beep0909/FerroAudioAmp/BOM.xls

PCB
Comment | Description | Designator | Footprint | LibRef | Quantity
100nF |  | C1, C3, C8 | 0603 | Cap | 3
33pF |  | C2 | 0603 | Cap | 1
10uF |  | C4, C7 | 0603 | Cap | 2
10nF |  | C5, C6 | 0603 | Cap | 2
RB521S30T1G | Diode Schottky 30V 200mA (DC) Surface Mount SOD-523 | D1, D2, D3, D4, D5, D6, D7, D8, D9, D10, D11, D12, D13, D14, D15, D16 | SOD523 | Diode Schottky | 16
B2B-XH-A(LF)(SN) | Connector Header Through Hole 2 position 0.098 (2.50mm) | J1, J2, J3, J4, J5, J6, J7, J8, J9, J10, J11, J12, J13, J14, J15, J16, POW1 | JST_B2B-XH-A(LF)(SN) | B2B-XH-A(LF)(SN) | 17
SJ1-3525N | 3.5 mm, Stereo, Right Angle, Through Hole, Audio Jack Connector | J_Audio1 | CUI_SJ1-3525N | SJ1-3525N | 1
100nH |  | L1 | 0603 | Ind | 1
DMN2056U-7 | N-Channel 20V 4A (Ta) 940mW Surface Mount SOT-23-3 | M1, M2, M3, M4, M5, M6, M7, M8, M9, M10, M11, M12, M13, M14, M15, M16 | SOT23_L | MOSFET-N | 16
MP1584EN_5V | DC-DC 6.5-28V in 5V out module | MD1 | MP1584EN_5V | MP1584EN_5V | 1
ARDUINO_NANO | ATSAMD21G18A Arduino Nano 33 IoT SAM D ARMÂ® CortexÂ®-M0+ MCU 32-Bit Embedded Evaluation Board | MD2 | SHIELD_ARDUINO_NANO | ARDUINO_NANO | 1
JUMPER 3 | Header, 3-Pin | P1 | HDR1X3 | Header 3 | 1
1K |  | R1, R2, R3, R4, R5, R6, R7, R8, R9, R10, R11, R12, R13, R14, R15, R16 | 0603 | Res | 16
200K |  | R17 | 0603 | Res | 1
1.2K |  | R18, R20, R24 | 0603 | Res | 3
0 |  | R19, R21, R22 | 0603 | Res | 3
22K |  | R23, R_L1, R_R1 | 0603 | Res | 3
MSGEQ7 | Seven Band Graphic Equalizer | U1 | DIP-8 | MSGEQ7 | 1
LM386 | Low Voltage Audio Power Amplifier | U2 | DIP-8 | LM386 | 1
2K | PC Pins Through Hole Trimmer Potentiometer Cermet 1 Turn Top Adjustment | VR1 | TRIM_3362P | 3362P | 1
10K | PC Pins Through Hole Trimmer Potentiometer Cermet 1 Turn Top Adjustment | VR2 | TRIM_3362P | 3362P | 1
DO NOT buy MSGEQ7 from China!!!!!!!!!!!!!!!!!
Get it from sparkfun!
Others
Item | Description | Quantity | Website
XY-S100L | 2.1 channel Bluetooth audio power amplifier module high and low bass subwoofer | 1 | https://www.aliexpress.com/item/1005002602440386.html
KK-P49/21 | Electric Magnet P49/21 Sucker DC 24V Lifting 40Kg 400N Solenoid Electromagnet | 1 | https://www.aliexpress.com/item/32548838511.html
Glass bottle | 125ml glass bottle | 1 | https://item.taobao.com/item.htm?spm=a1z09.2.0.0.2a902e8dQaJcZc&id=628821882199&_u=oufkvpbafc4
24V adapter | 24V 5A adapter | 1 | Amazon
JST XH 2.54 2p plug | 100Sets XH Pitch 2.54mm 2Pin Single-Head Wire To Board Connector 10cm 26AWG With Socket | 2 | https://www.aliexpress.com/item/32866129450.html?pdp_ext_f=%7B%22sku_id%22%3A%2265537364588%22%7D
24V Led strip |  | 1 | Amazon or Aliexpress
Speaker | build-in speaker | 2 | https://www.aliexpress.com/item/32816252198.html?pdp_ext_f=%7B%22sku_id%22%3A%2264715469662%22%7D
Speaker | Passive Speaker | 2 | Amazon
Ferrorfluid | EFH1 Ferrorfluid 50ml | 1 | Amazon
Screw | M2 x 6mm | 4 | Amazon
Screw | self tapping 4G x12mm | 10 | Amazon
M2 Screw Spacer | 3mm + 3mm M2 spacer | 4 | Amazon
Audio cable | 3.5mm jack audio cable | 1 | Amazon
Guide to make ferrofluid bottle:
1. Wash glass bottle with 99.8% IPA and then add 100ml saturated salt (NaCl) solution. 2. Add approx. 30ml ferrofluid.
