beep0909/FerroAudioAmp/Casing/Build-in Speaker Version/MagCap.SLDPRT

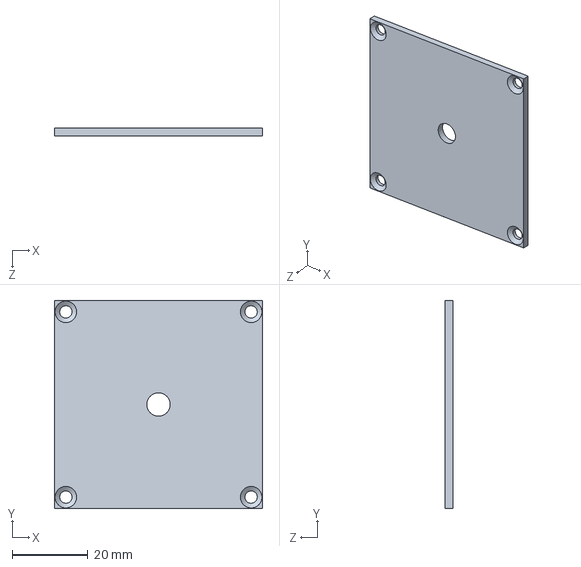
[picture p1: CAD file, 2022-01-24]
Casing/Build-in Speaker Version/MagCap.SLDPRT
55.0 x 55.0 x 2.00 mm
