beep0909/FerroAudioAmp/Casing/Build-in Speaker Version/InnerCap-spk.SLDPRT

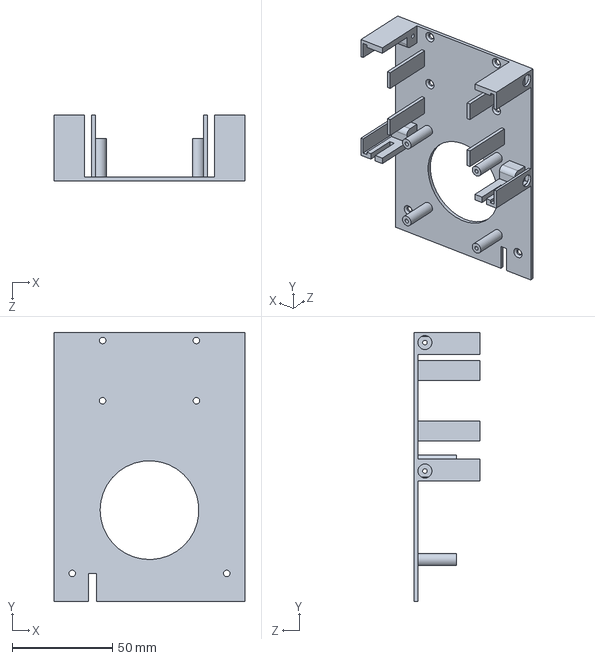
[picture p2: CAD file, 2022-01-24]
Casing/Build-in Speaker Version/InnerCap-spk.SLDPRT
95.0 x 134.0 x 33.0 mm
