beep0909/FerroAudioAmp/Casing/External Passive Speaker Version/Case2.SLDPRT

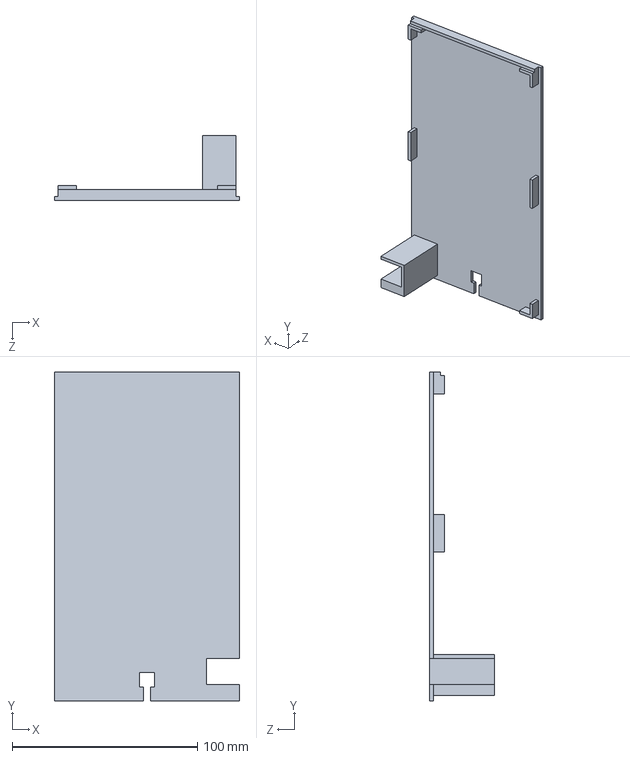
[picture p3: CAD file, 2022-01-24]
Casing/External Passive Speaker Version/Case2.SLDPRT
100.0 x 177.5 x 35.0 mm
