beep0909/FerroAudioAmp/Casing/Build-in Speaker Version/Case1-spk.SLDPRT

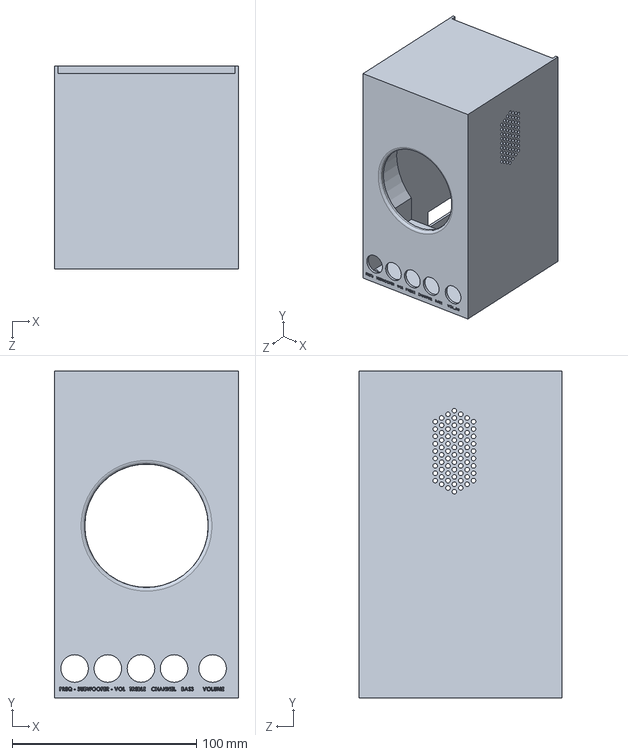
[picture p4: CAD file, 2022-01-24]
Casing/Build-in Speaker Version/Case1-spk.SLDPRT
100.0 x 177.5 x 110.0 mm
