beep0909/FerroAudioAmp/Casing/Build-in Speaker Version/MagGaper.SLDPRT

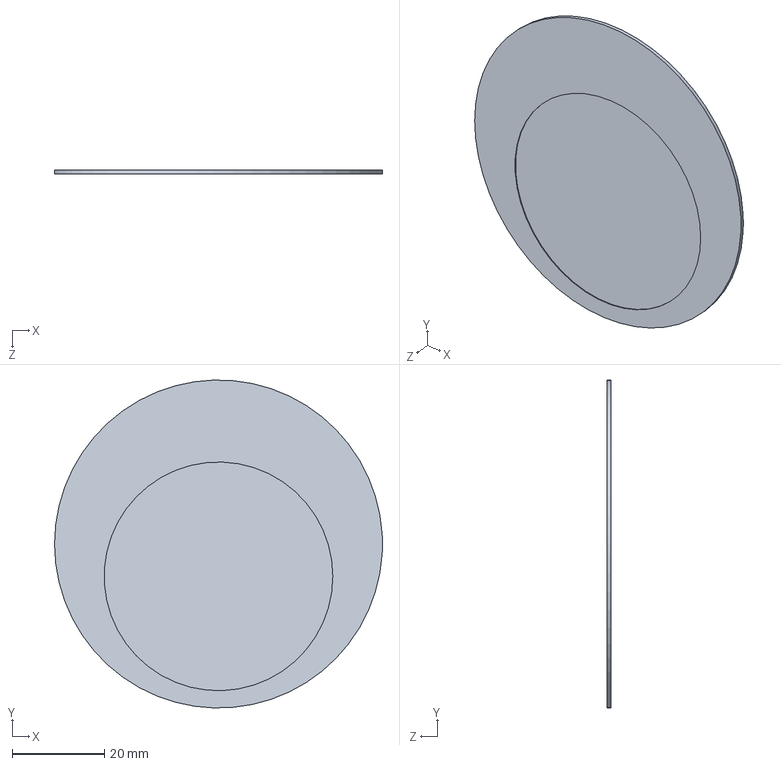
[picture p5: CAD file, 2022-01-24]
Casing/Build-in Speaker Version/MagGaper.SLDPRT
71.0 x 71.0 x 0.8 mm
