beep0909/FerroAudioAmp/Casing/External Passive Speaker Version/InnerCap.SLDPRT

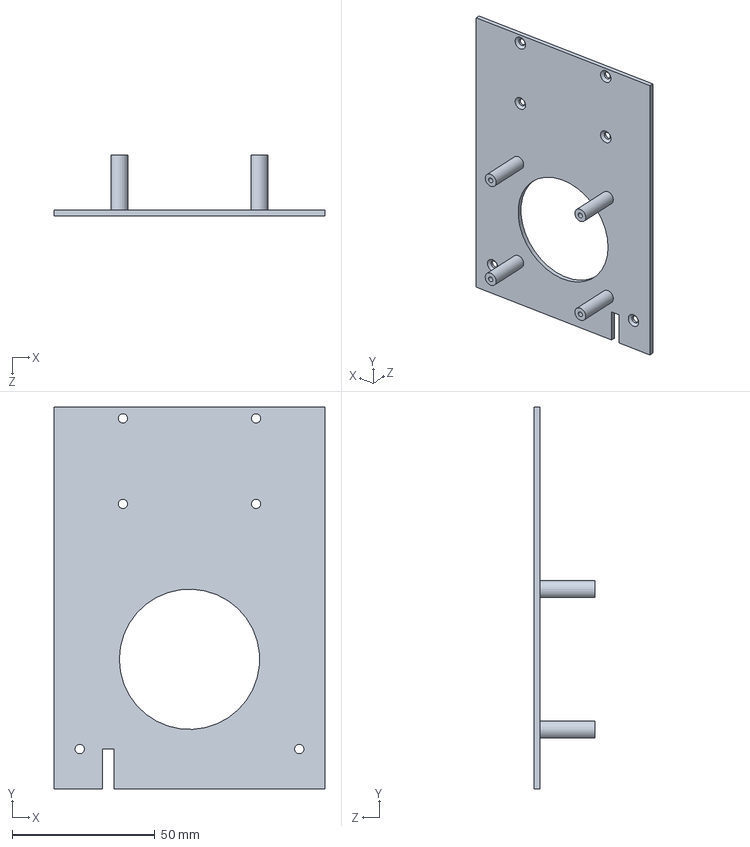
[picture p6: CAD file, 2022-01-24]
Casing/External Passive Speaker Version/InnerCap.SLDPRT
95.0 x 134.0 x 21.3 mm
