beep0909/FerroAudioAmp/(list of files, cad)

Other CAD files:
Casing/External Passive Speaker Version/Case1.SLDPRT
Casing/Build-in Speaker Version/Case2-spk.SLDPRT
Casing/Build-in Speaker Version/Case1-spk.STL
Casing/Build-in Speaker Version/Case2-spk.STL
Casing/Build-in Speaker Version/InnerCap-spk.STL
Casing/Build-in Speaker Version/MagCap.STL
Casing/Build-in Speaker Version/MagGaper.STL
Casing/External Passive Speaker Version/Case1.STL
Casing/External Passive Speaker Version/Case2.STL
Casing/External Passive Speaker Version/InnerCap.STL
Casing/External Passive Speaker Version/MagCap.STL
Casing/External Passive Speaker Version/MagGaper.STL
