beep0909/FerroAudioAmp/FerroAudioAmp_PCB/FerroAudioAmp_PCB.pdf

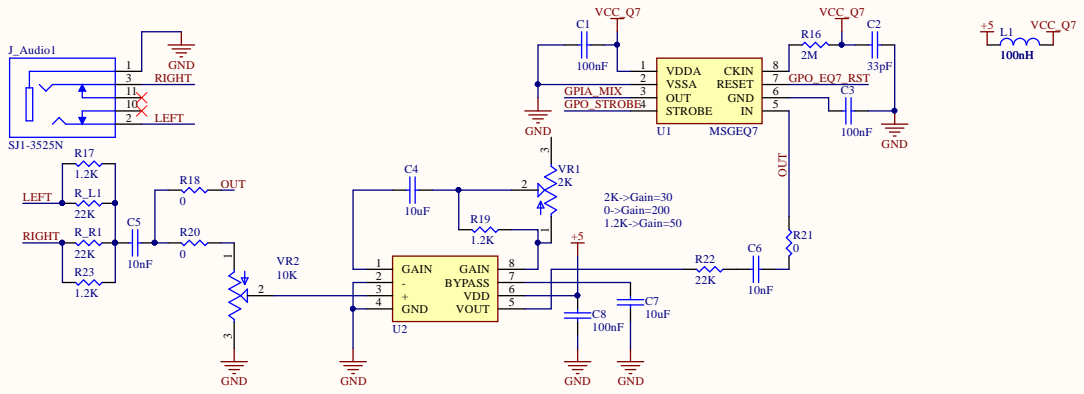
[picture p7: page 1]

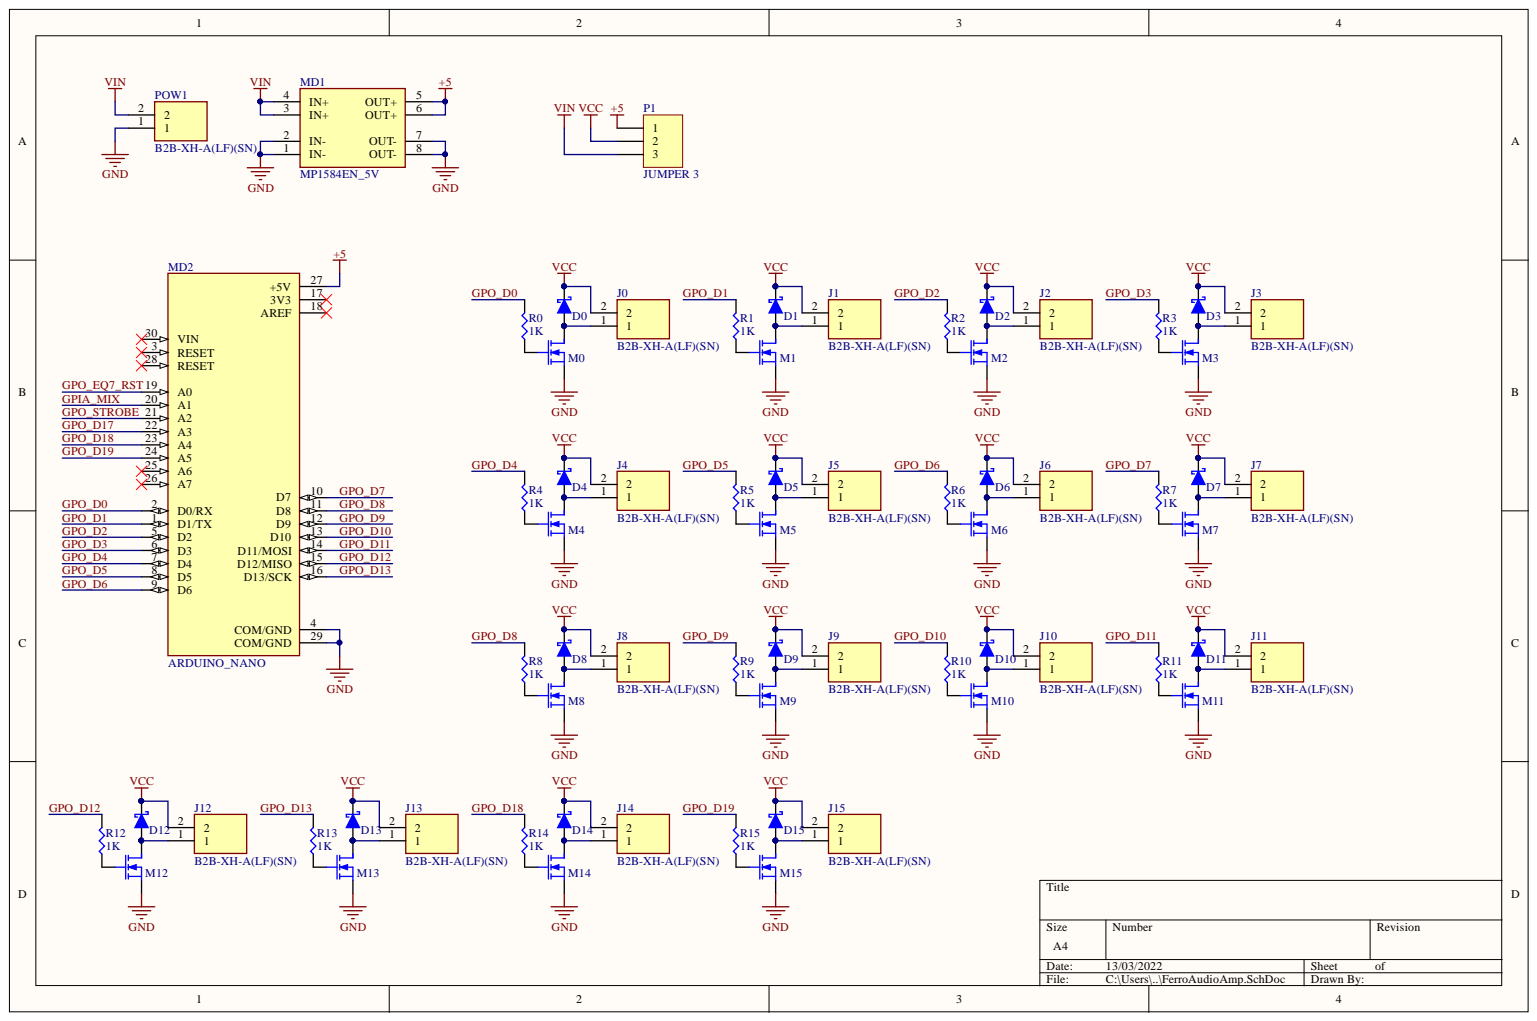
[picture p8: page 2]

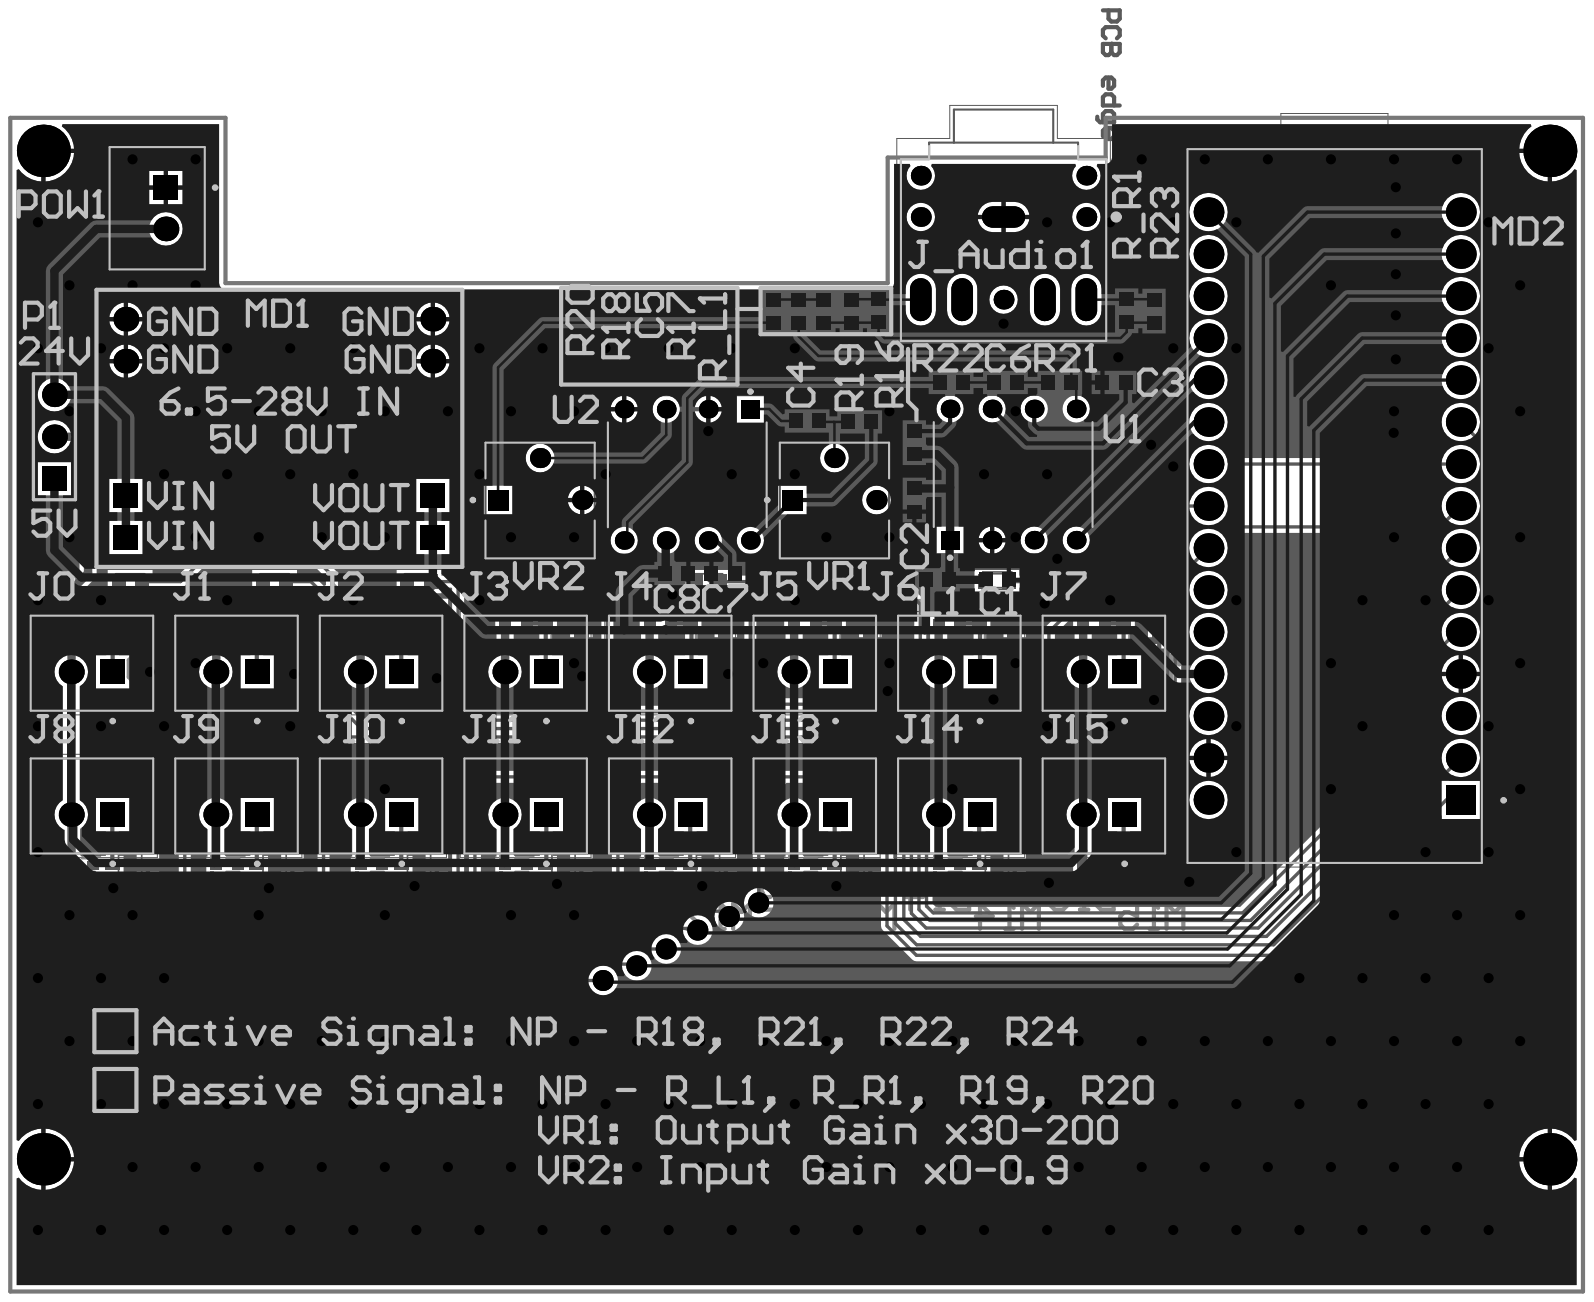
[picture p9: page 3]

# Board Stack Report
