beep0909/FerroAudioAmp/(list of files, drawings)

Other design files:
FerroAudioAmp_PCB/AnalogSignal.SchDoc
FerroAudioAmp_PCB/FerroAudioAmp.PcbLib
FerroAudioAmp_PCB/FerroAudioAmp.SchDoc
FerroAudioAmp_PCB/FerroAudioAmp.SchLib
FerroAudioAmp_PCB/FerroAudioAmp_PCB.PrjPcb
