beep0909/FerroAudioAmp/(commit log)

2021-11-27 PCB V0.1
    [FerroAudioAmp.PcbLib, FerroAudioAmp.SchDoc, FerroAudioAmp.SchLib, FerroAudioAmp_PCB.PrjPcb]
2021-12-14 Add op amp circuit
    [AnalogSignal.SchDoc, FerroAudioAmp.SchDoc, FerroAudioAmp_PCB.PrjPcb]
2021-12-18 Update PCB design
    [AnalogSignal.SchDoc, FerroAudioAmp.PcbLib, FerroAudioAmp.SchDoc, FerroAudioAmp.SchLib, FerroAudioAmp_PCB.PrjPcb]
2021-12-18 update PCB
2022-01-24 add Casing 3D file and Code for Arduino nano
    [AnalogSignal.SchDoc, Case1-spk.SLDPRT, Case1-spk.STL, Case1.SLDPRT, Case1.STL, Case2-spk.SLDPRT, Case2-spk.STL, Case2.SLDPRT]
2022-01-24 add BOM
    [BOM.xls]
2022-03-12 Match Designator Number with Arduino Pin Number
    [AnalogSignal.SchDoc, FerroAudioAmp.SchDoc]
2022-03-12 add Instructions File
    [BOM.xls]
